leafony/av06-1v8-5v5/kicad/leafony-av06-1v8-5v5/panelized/bom-leafony-av06-1v8-5v5-pcbgogo.xlsx

 |  |  | Leafony AV06 1.8V〜5.5V 1PCS BOM
Item # | *Ref Des | *Qty | Manufacturer | *Mfg Part # | Description / Value | *Package | Type | Your Instructions / Notes
1 | C1, C7 | 2 | Murata Electronics | GRM155R61H105ME05D | CAP CER 1UF 50V X5R 0402 | 0402 | SMD
2 | C2 | 1 | Murata Electronics | GRM1555C1H221JA01D | CAP CER 200pF 50V C0G 0402 | 0402 | SMD
3 | C3, C4 | 2 | Murata Electronics | GRM155R71H104KE14D | CAP CER 0.1UF 50V X7R 0402 | 0402 | SMD
4 | C5 | 1 | Murata Electronics | GRM21BR61E226ME44L | CAP CER 22UF 25V X5R 0805 | 0805 | SMD
5 | C6 | 1 | Murata Electronics | GRM21BR61A476ME15L | CAP CER 47UF 10V X5R 0805 | 0805 | SMD
6 | J1 | 1 | JST Sales America Inc. | S2B-PH-SM4-TB | CONN HEADER SMD R/A 2POS 2MM | 1x2pin conn | SMD
7 | L1 | 1 | Murata Electronics | DFE252012PD-1R0M=P2 | FIXED IND 1UH 3.2A 0.042OHM SMD | 1008 | SMD
8 | R1 | 1 | YAGEO | RC0402FR-07100KL | RES 100K OHM 1% 1/16W 0402 | 0402 | SMD
9 | R2 | 1 | YAGEO | RC0402FR-0710ML | RES 10M OHM 1% 1/16W 0402 | 0402 | SMD
10 | R3 | 1 | YAGEO | RC0402FR-071KL | RES 1K OHM 1% 1/16W 0402 | 0402 | SMD
11 | R4, R5 | 2 | YAGEO | RC0402FR-071ML | RES 1M OHM 1% 1/16W 0402 | 0402 | SMD
12 | R6 | 1 | YAGEO | RC0402FR-0710RL | RES 10 OHM 1% 1/16W 0402 | 0402 | SMD
13 | R7, R8 | 0 | ~ | ~ | ~ | ~ | ~
14 | R9 | 1 | YAGEO | RC0402FR-0791KL | RES 91K OHM 1% 1/16W 0402 | 0402 | SMD
15 | R10 | 1 | YAGEO | RC0402FR-07511KL | RES 511K OHM 1% 1/16W 0402 | 0402 | SMD
16 | R11 | 1 | YAGEO | RC0402JR-070RL | RES 0 OHM JUMPER 1/16W 0402 | 0402 | SMD
17 | SW1 | 1 | Nidec Components Corporation | CUS-12TB | SWITCH SLIDE SPDT 300MA 4V | CUS-12TB | SMD
18 | U1 | 1 | Texas Instruments | TPS22917DBVR | IC PWR SWITCH P-CHAN 1:1 SOT23-6 | SOT23-6 | SMD
19 | U2 | 1 | Texas Instruments | ADC081C027CIMK/NOPB | IC ADC 8BIT SAR TSOT23-6 | SOT23-6 | SMD
20 | U3 | 1 | Texas Instruments | TPS631010YBGR | IC REG BUCK BST ADJ 1.5A 8DSBGA | 8-XFBGA | SMD
21 | U4 | 1 | Analog Devices Inc./Maxim Integrated | MAX40200ANS+T | IC DIODE CURRENT SWITCH 4WLP | 4WLP | SMD
