leafony/av06-1v8-5v5/output/schematic.pdf

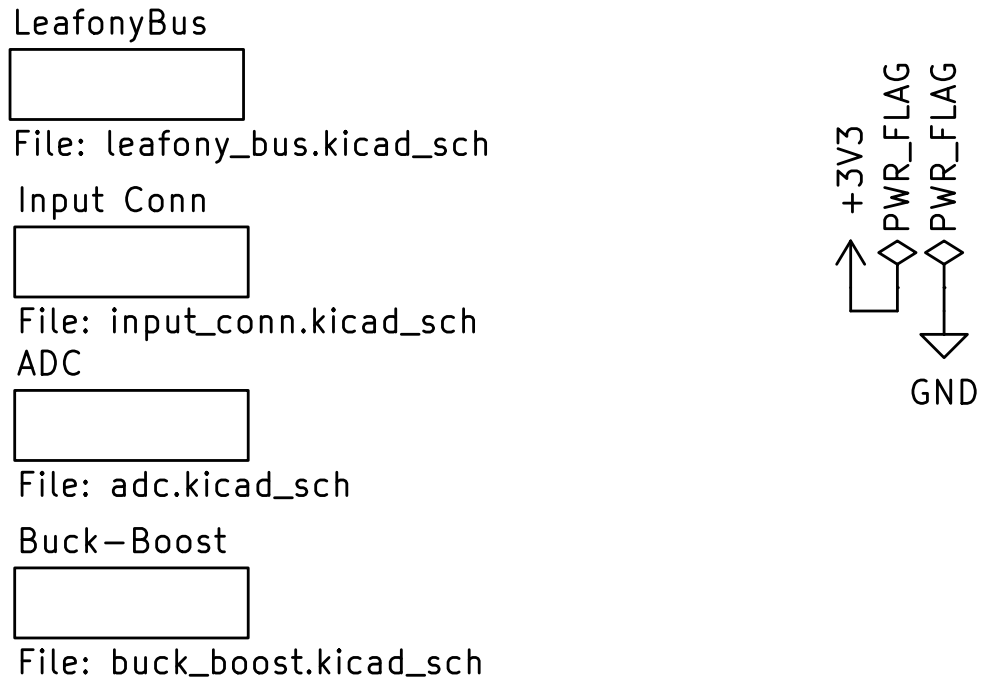
[picture p3: page 1]

File: adc.kicad_sch Buck-Boost File: buck_boost.kicad_sch

Leafony Systems Inc.
Sheet: /
File: leafony-av06-1v8-5v5.kicad_sch
Title: Leafony AV06 Buck Boost

Size: A4 | Rev: v1.0
KiCad E.D.A. 10.0.8 | Id: 1/5

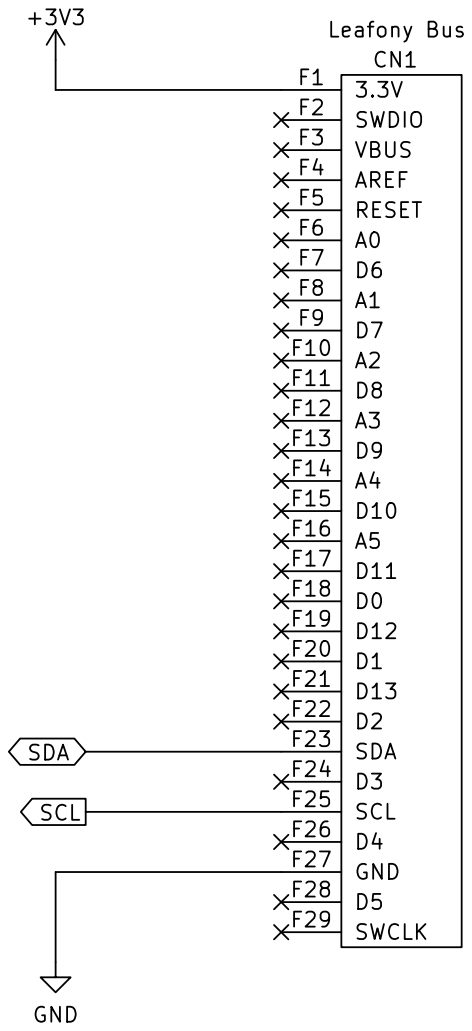
[picture p4: page 2]

Leafony Systems Inc. GND +3V3
Leafony Bus SDA SCL
SWDIO F2
VBUS F3

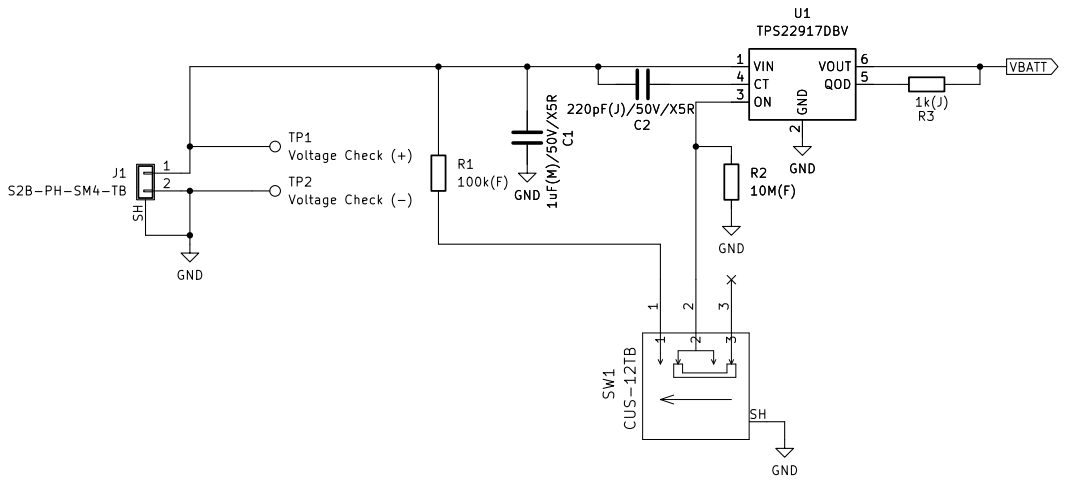
[picture p5: page 3]

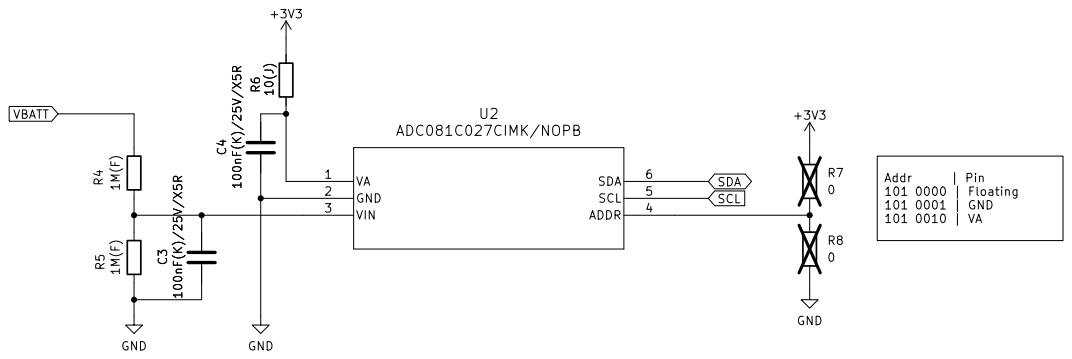
[picture p6: page 4]

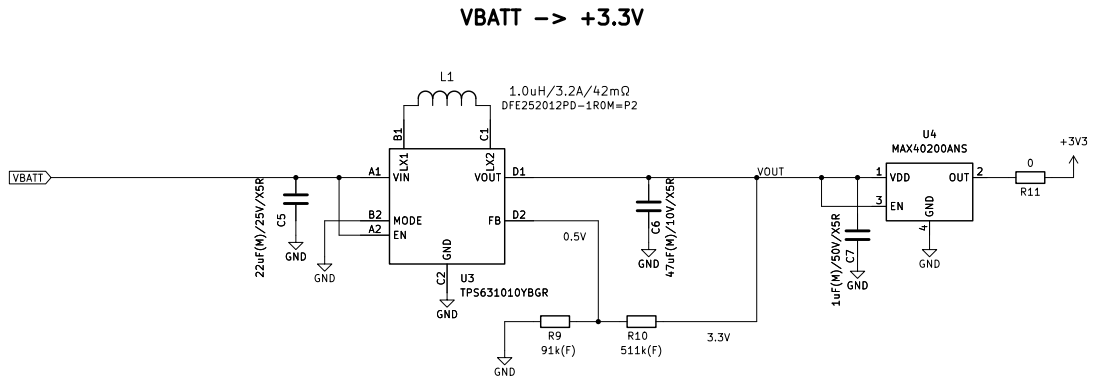
[picture p7: page 5]

Leafony Systems Inc. GND
