leafony/av06-1v8-5v5/output/layout.pdf

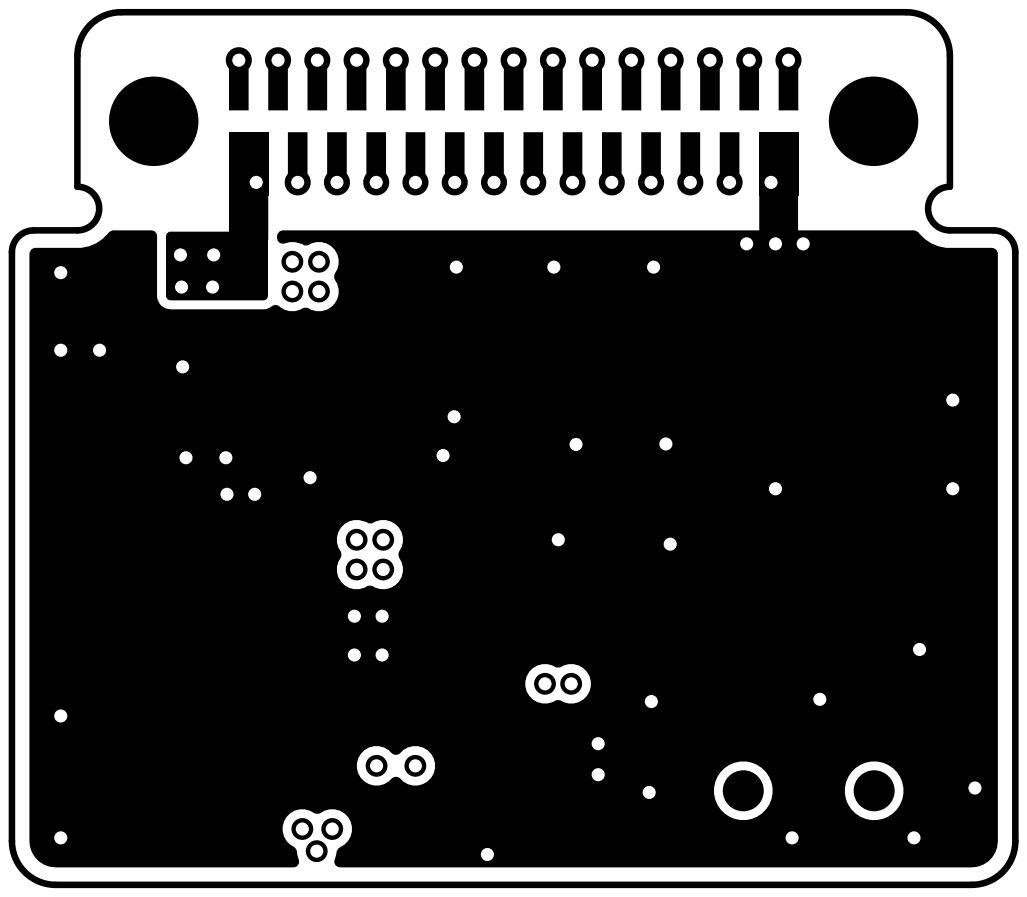
[picture p8: page 1]

Size: A4 | Rev: v1.0
KiCad E.D.A. 10.0.8 | Id: 1/6

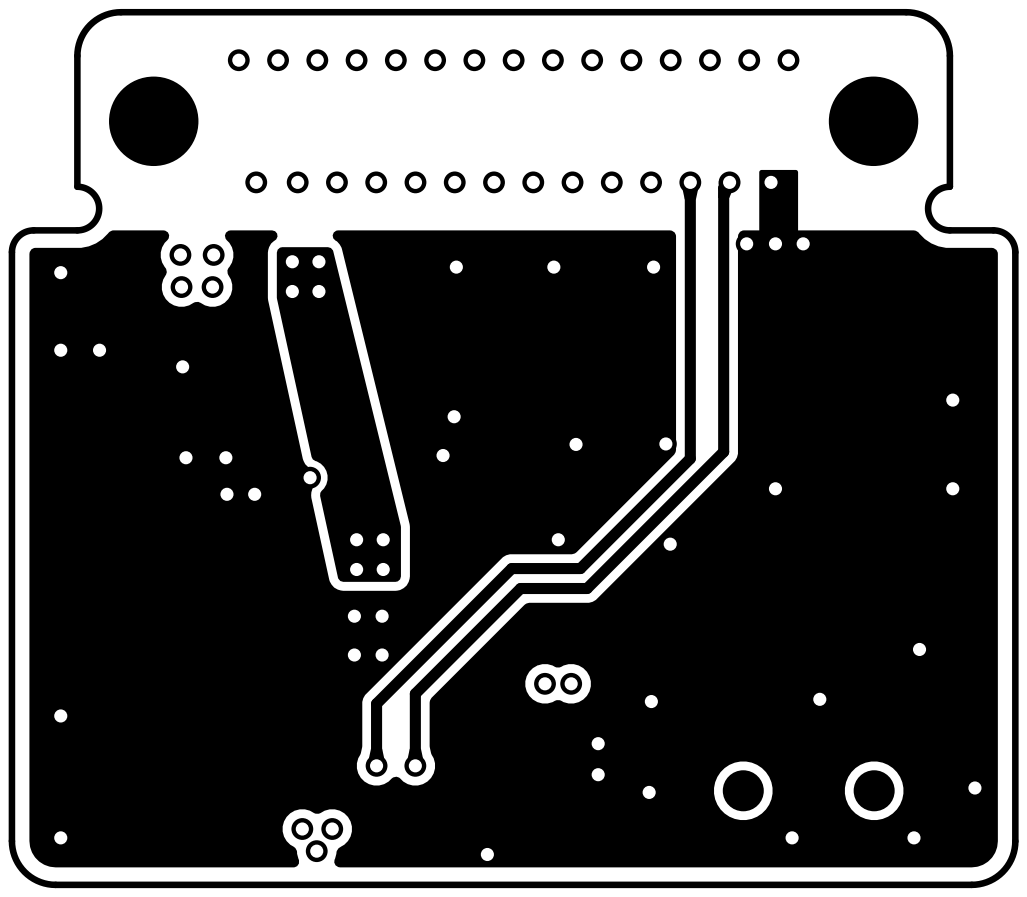
[picture p9: page 2]

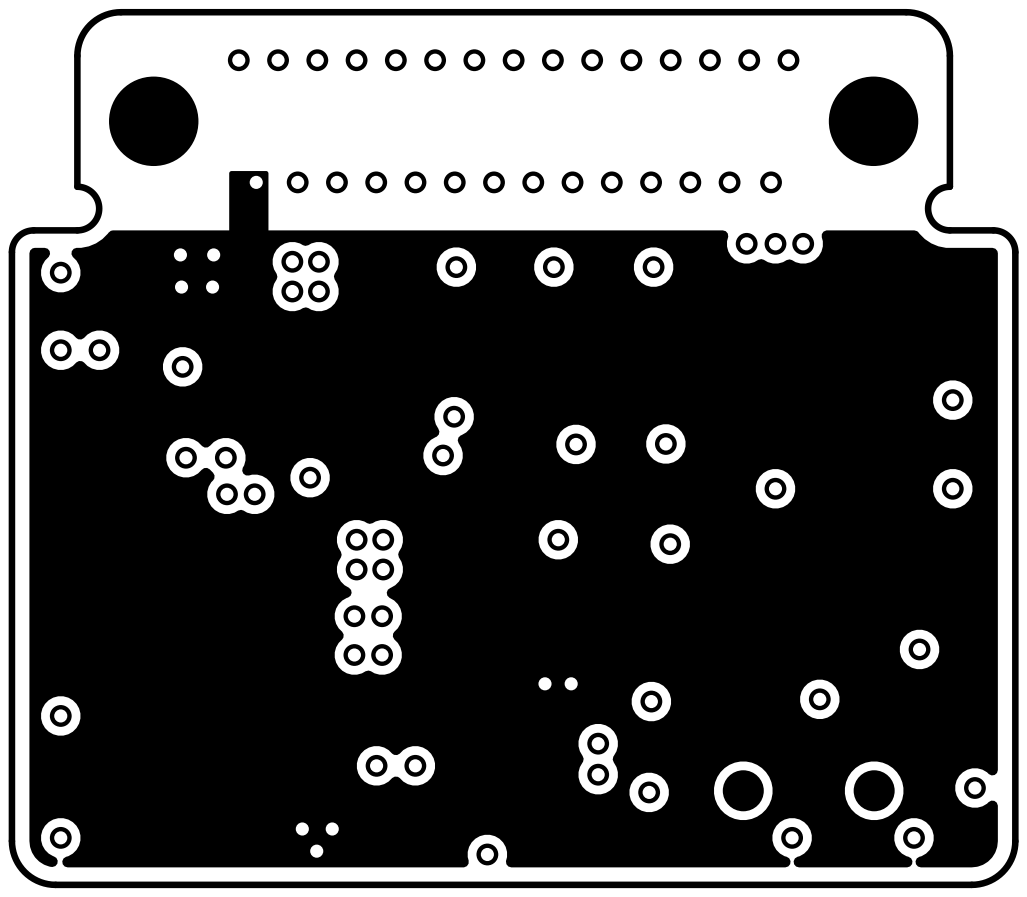
[picture p10: page 3]

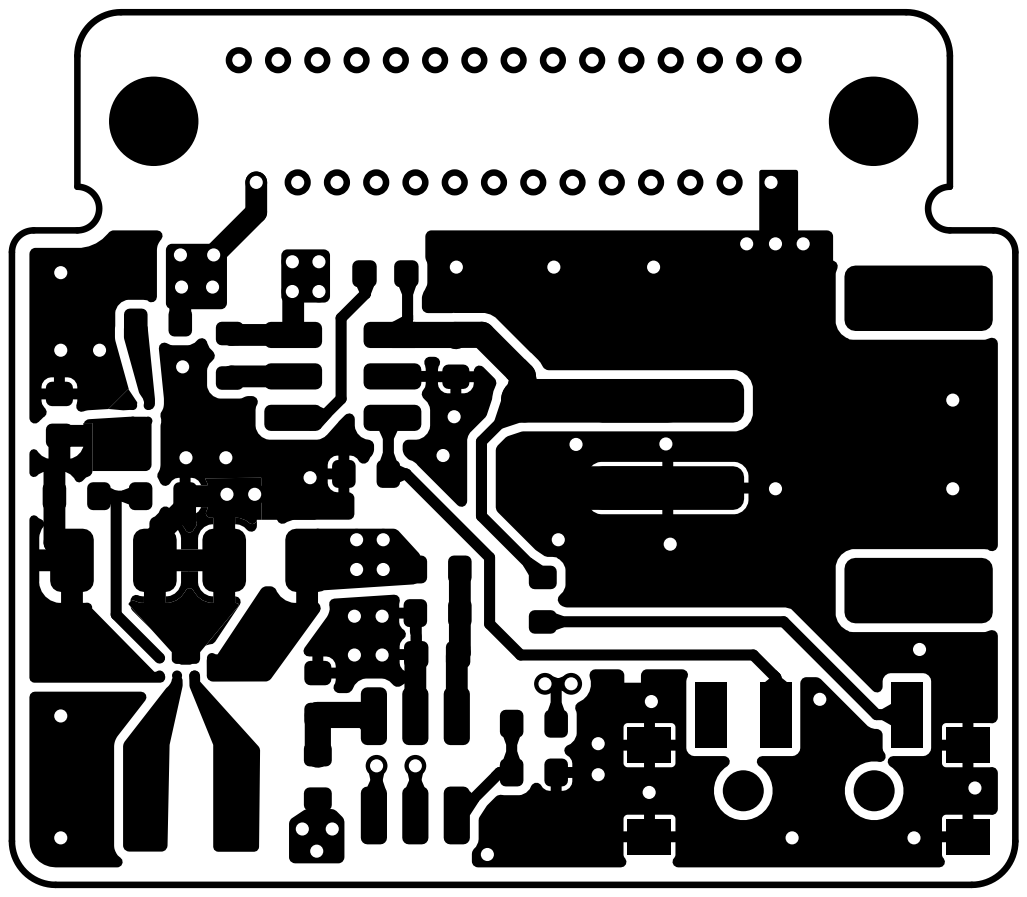
[picture p11: page 4]

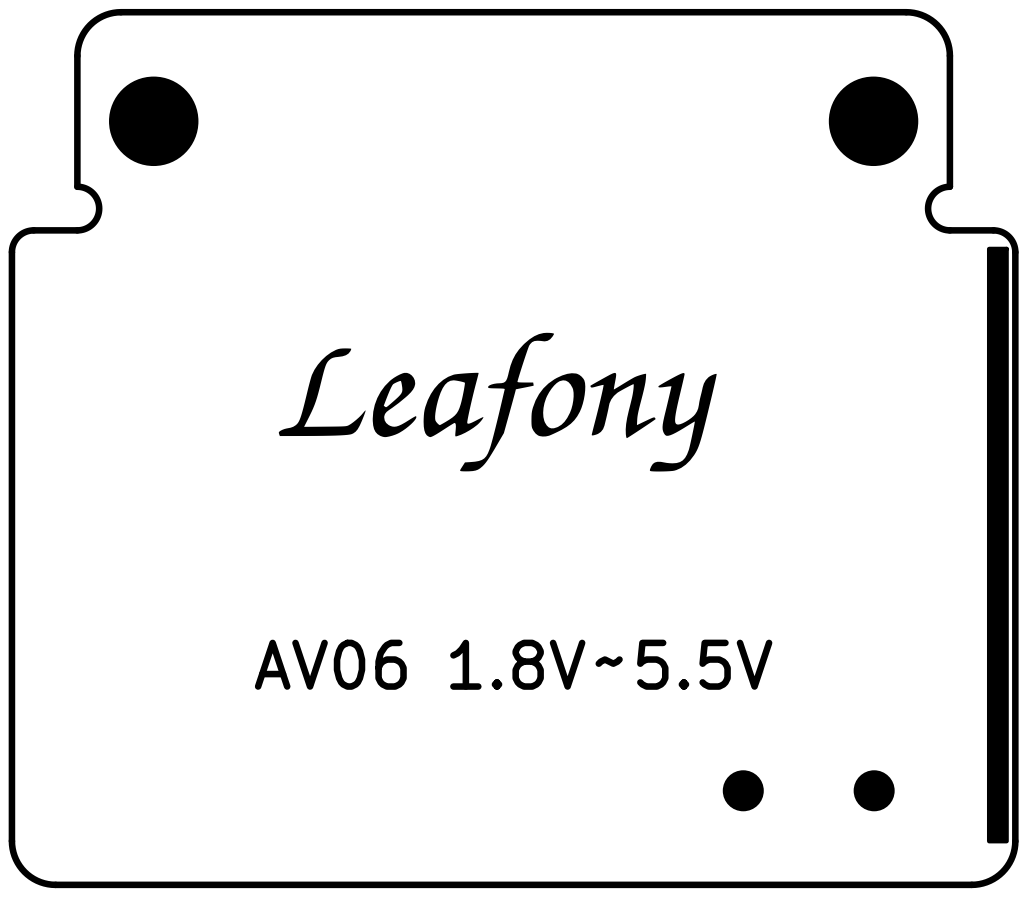
[picture p12: page 5]

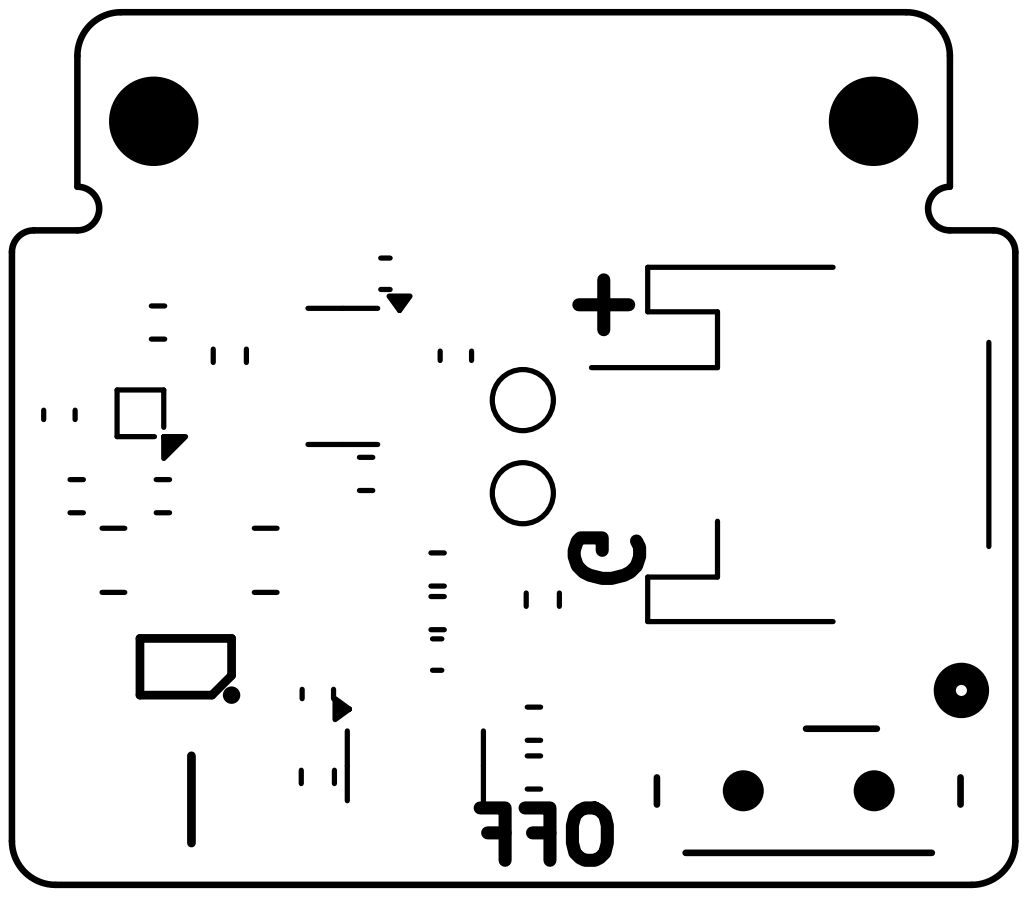
[picture p13: page 6]
