leafony/av06-1v8-5v5/kicad/leafony-av06-1v8-5v5/leafony-av06-1v8-5v5.kicad_pcb

## KiCad design kicad/leafony-av06-1v8-5v5/leafony-av06-1v8-5v5.kicad_pcb (2026-09-25)

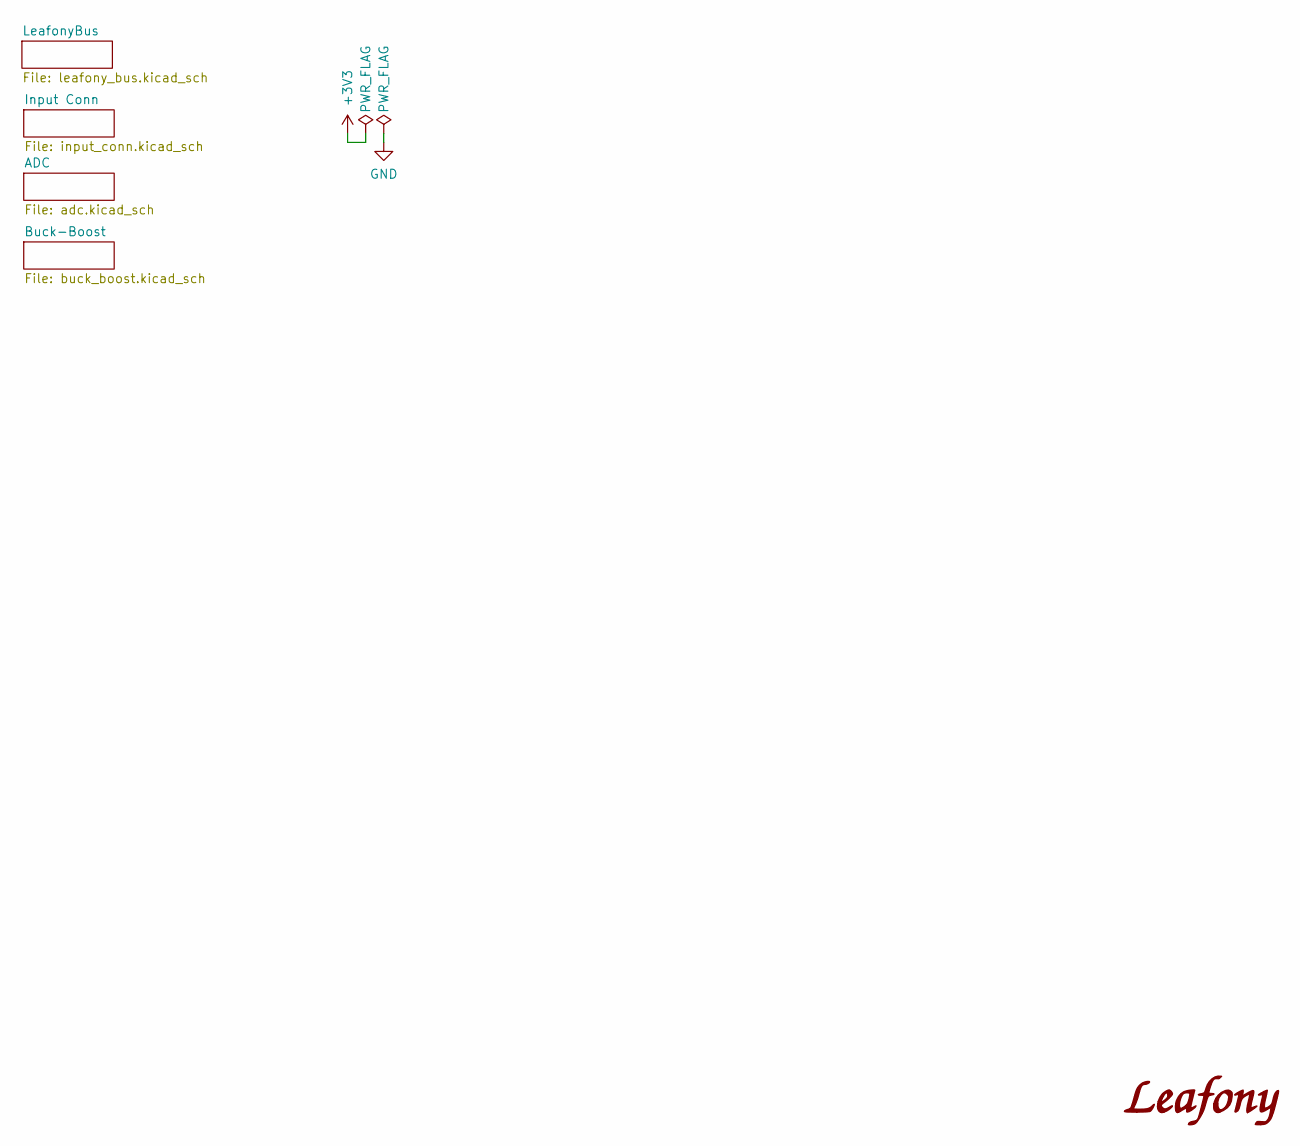
[picture p14: schematic leafony-av06-1v8-5v5.kicad_sch, Leafony AV06 Buck Boost]

Parts:
LOGO1: LOGO; LEAFONY_LOGO

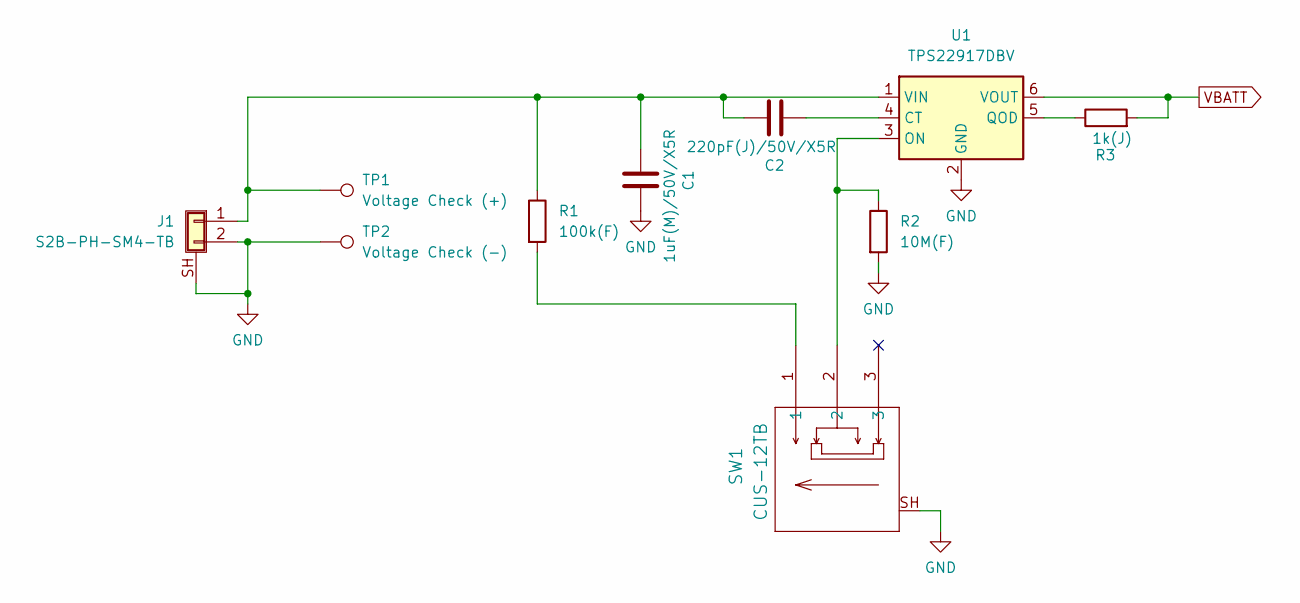
[picture p15: schematic input_conn.kicad_sch, Leafony AV04 2-4.5V Leaf]

Parts:
C1: 1uF(M)/50V/X5R; C_0402_1005Metric
C2: 220pF(J)/50V/X5R; C_0402_1005Metric
J1: S2B-PH-SM4-TB; JST_PH_S2B-PH-SM4-TB_1x02-1MP_P2.00mm_Horizontal
R1: 100k(F); R_0402_1005Metric
R2: 10M(F); R_0402_1005Metric
R3: 1k(J); R_0402_1005Metric
SW1: CUS-12TB; CUS-12TB_NDC
TP1: Voltage Check (+); TestPoint_Pad_D1.0mm
TP2: Voltage Check (-); TestPoint_Pad_D1.0mm
U1: TPS22917DBV; SOT-23-6

Connections:
GND: C1.1, J1.2, J1.SH (Shield), R2.2, SW1.SH, TP2.1, U1.2 (GND); also elsewhere on the board
unnamed: C1.2, C2.1, J1.1, R1.1, TP1.1, U1.1 (VIN)
unnamed: R1.2, SW1.1
unnamed: C2.2, U1.4 (CT)
unnamed: R2.1, SW1.2, U1.3 (ON)
unnamed: R3.1, U1.5 (QOD)
VBATT: R3.2, U1.6 (VOUT); also elsewhere on the board

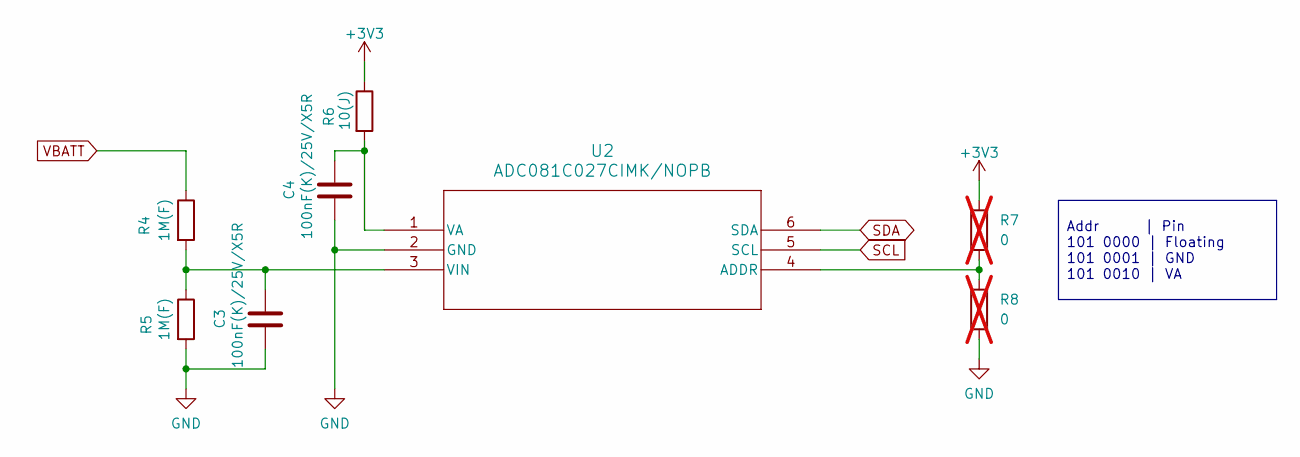
[picture p16: schematic adc.kicad_sch, Leafony AV04 2-4.5V Leaf]

Parts:
C3, C4: 100nF(K)/25V/X5R; C_0402_1005Metric
R4, R5: 1M(F); R_0402_1005Metric
R6: 10(J); R_0402_1005Metric
R7, R8: 0; R_0402_1005Metric; not fitted
U2: ADC081C027CIMK/NOPB; SOT-23-6

Connections:
+3V3: R6.1, R7.1; also elsewhere on the board
GND: C3.2, C4.2, R5.2, R8.2, U2.2 (GND); also elsewhere on the board
unnamed: R7.2, R8.1, U2.4 (ADDR)
unnamed: C4.1, R6.2, U2.1 (VA)
unnamed: C3.1, R4.2, R5.1, U2.3 (VIN)
SCL: U2.5 (SCL); also elsewhere on the board
SDA: U2.6 (SDA); also elsewhere on the board
VBATT: R4.1; also elsewhere on the board

Notes on the sheet:
Addr | Pin 101 0000 | Floating 101 0001 | GND 101 0010 | VA

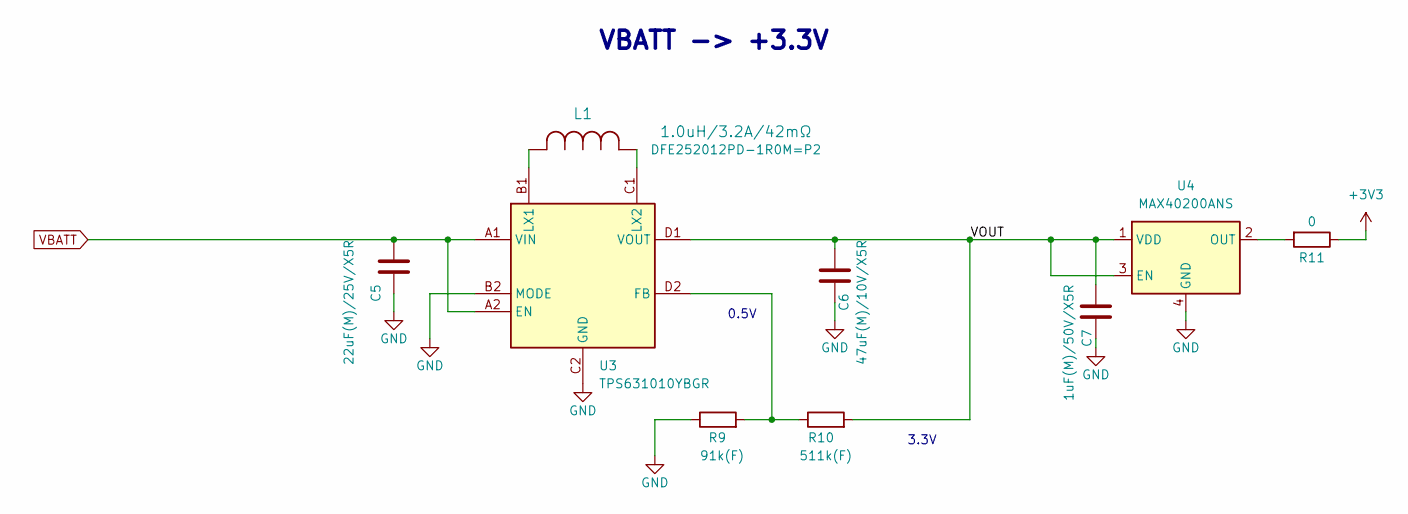
[picture p17: schematic buck_boost.kicad_sch, Leafony AV04 2-4.5V Leaf]

Parts:
C5: 22uF(M)/25V/X5R; C_0805_2012Metric
C6: 47uF(M)/10V/X5R; C_0805_2012Metric
C7: 1uF(M)/50V/X5R; C_0402_1005Metric
L1: 1.0uH/3.2A/42mΩ; DFE2HCAH1R0MJ0L
R9: 91k(F); R_0402_1005Metric
R10: 511k(F); R_0402_1005Metric
R11: 0; R_0402_1005Metric
U3: TPS631010YBGR; TPS631010; Manufacturer_Part_Number TPS631010YBGR
U4: MAX40200ANS; WLP-4_0.73x0.73mm_Layout2x2_P0.35mm_Ball0.22mm_Pad0.2mm

Connections:
+3V3: R11.1; also elsewhere on the board
/Buck-Boost/VOUT: C6.1, C7.1, R10.2, U3.D1 (VOUT), U4.1 (VDD), U4.3 (EN)
GND: C5.2, C6.2, C7.2, R9.1, U3.B2 (MODE), U3.C2 (GND), U4.4 (GND); also elsewhere on the board
unnamed: R9.2, R10.1, U3.D2 (FB)
unnamed: L1.2, U3.B1 (LX1)
unnamed: L1.1, U3.C1 (LX2)
unnamed: R11.2, U4.2 (OUT)
VBATT: C5.1, U3.A1 (VIN), U3.A2 (EN); also elsewhere on the board

Notes on the sheet:
0.5V
3.3V
VBATT -> +3.3V

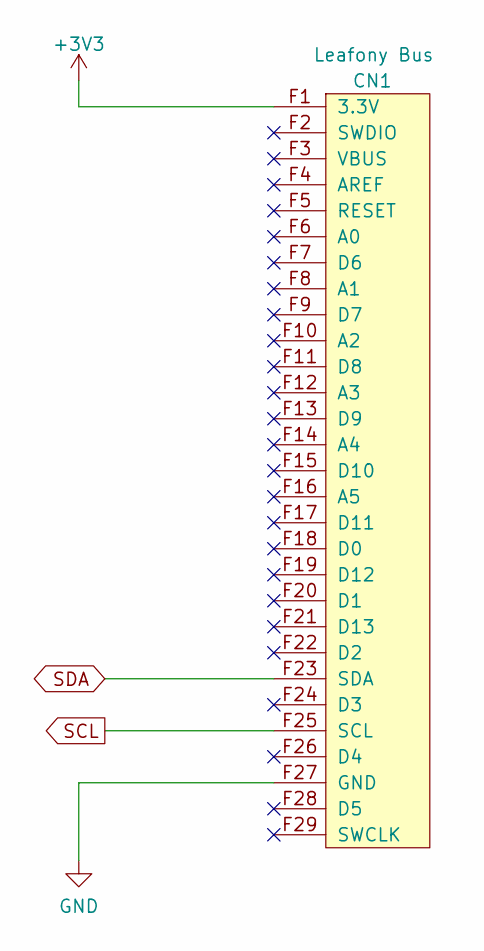
[picture p18: schematic leafony_bus.kicad_sch, Leafony AV04 2-4.5V Leaf]

Parts:
CN1: Leafony Bus; CN_F29

Connections:
+3V3: CN1.F1 (3.3V); also elsewhere on the board
GND: CN1.F27 (GND); also elsewhere on the board
SCL: CN1.F25 (SCL); also elsewhere on the board
SDA: CN1.F23 (SDA); also elsewhere on the board

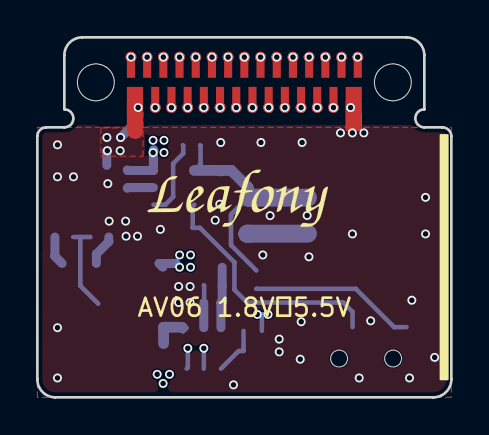
[picture p19: board leafony-av06-1v8-5v5.kicad_pcb from above]

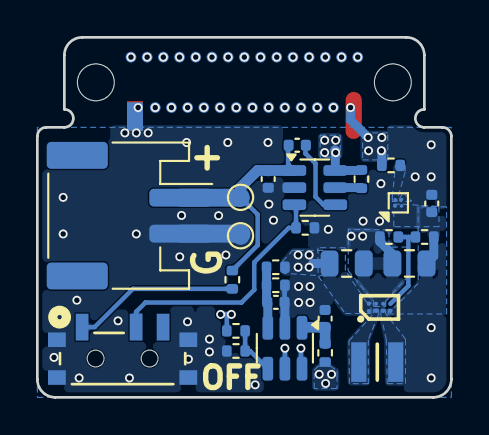
[picture p20: board leafony-av06-1v8-5v5.kicad_pcb from below]

Board: 4 copper layers, 23.0 x 20.0 mm, 29 parts (27 on the bottom side), 18 nets.
